kthfspe/KICAD_infrastructure/KICAD_blocks/buck_converter_26to12.kicad_sch

## KiCad design KICAD_blocks/buck_converter_26to12.kicad_sch (2026-01-20)

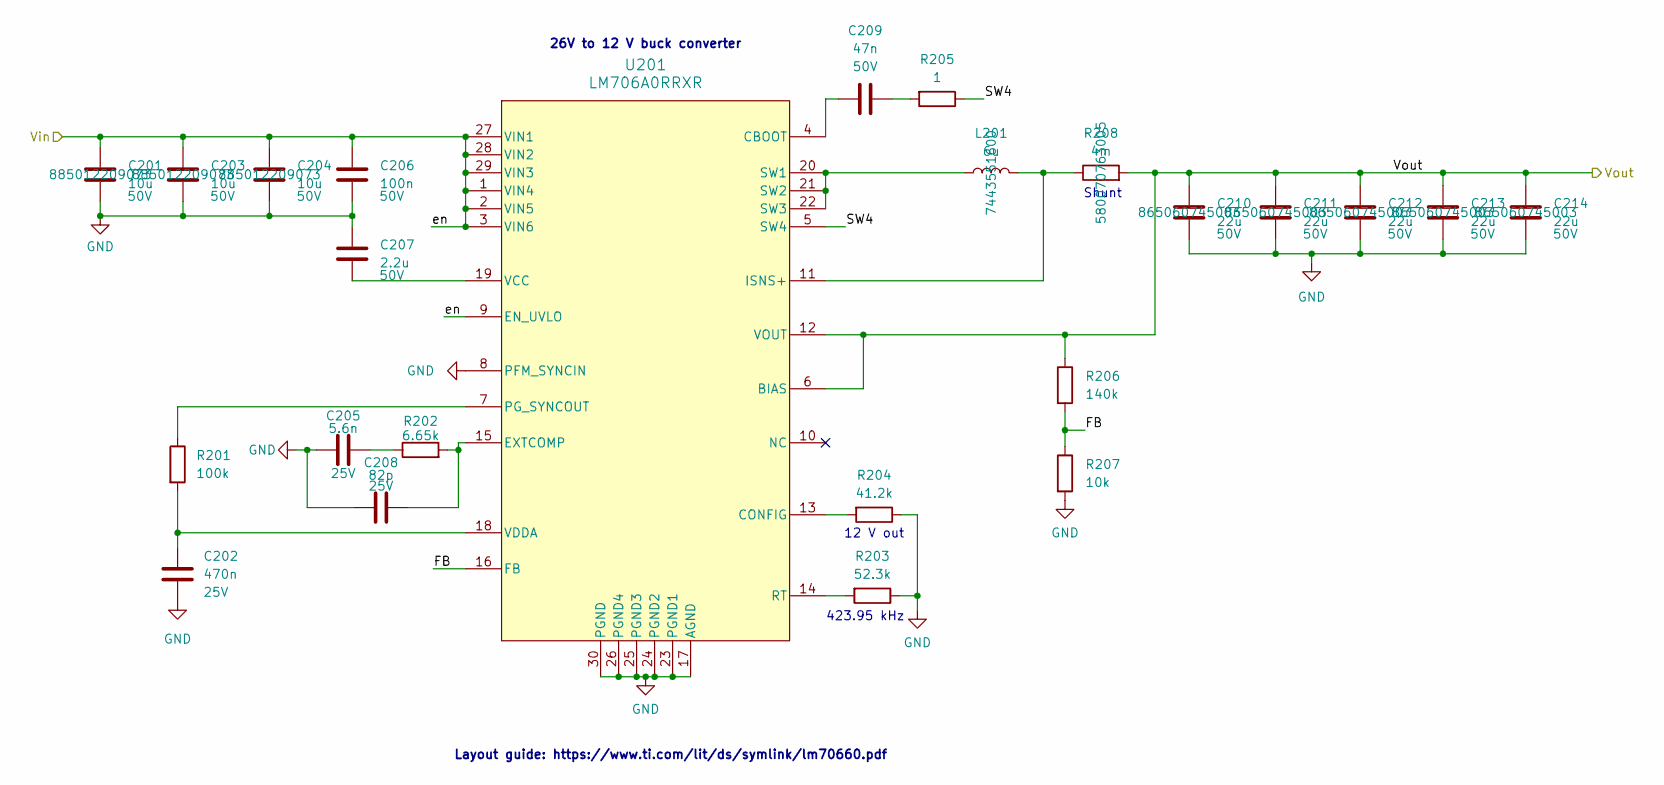
[picture p1: schematic buck_converter_26to12.kicad_sch]

Parts:
C201, C203, C204: 10u; C_1210_3225Metric; Part Number 885012209073
C202: 470n; C_0603_1608Metric
C205: 5.6n; C_0603_1608Metric
C206: 100n; C_0603_1608Metric
C207: 2.2u; C_1210_3225Metric
C208: 82p; C_0603_1608Metric
C209: 47n; C_0603_1608Metric
C210, C211, C212, C213, C214: 22u; CP_Elec_6.3x7.7; Part Number 865060745003
L201: 6u; L_Wurth_WE-HCI-1365; Part Number 7443551600
R201: 100k; R_0603_1608Metric
R202: 6.65k; R_0603_1608Metric
R203: 52.3k; R_0603_1608Metric
R204: 41.2k; R_0603_1608Metric
R205: 1; R_0603_1608Metric
R206: 140k; R_0603_1608Metric
R207: 10k; R_0603_1608Metric
R208: 4m; R_2512_6332Metric; Part Number 580070763005
U201: LM706A0RRXR; RRX0029B-MFG

Connections:
FB: R206.2, R207.1, U201.16 (FB)
GND: C201.2, C202.2, C203.2, C204.2, C205.2, C206.2, C207.1, C208.2, C210.2, C211.2, C212.2, C213.2, C214.2, R203.1, R204.1, R207.2, U201.8 (PFM_SYNCIN), U201.17 (AGND), U201.23 (PGND1), U201.24 (PGND2), U201.25 (PGND3), U201.26 (PGND4), U201.30 (PGND)
unnamed: C202.1, R201.2, U201.18 (VDDA)
unnamed: C205.1, R202.1
unnamed: C207.2, U201.19 (VCC)
unnamed: C208.1, R202.2, U201.15 (EXTCOMP)
unnamed: C209.1, U201.4 (CBOOT)
unnamed: C209.2, R205.2
unnamed: L201.1, U201.20 (SW1), U201.21 (SW2), U201.22 (SW3)
unnamed: L201.2, R208.1, U201.11 (ISNS+)
unnamed: R201.1, U201.7 (PG_SYNCOUT)
unnamed: R203.2, U201.14 (RT)
unnamed: R204.2, U201.13 (CONFIG)
SW4: R205.1, U201.5 (SW4)
Vout: C210.1, C211.1, C212.1, C213.1, C214.1, R206.1, R208.2, U201.6 (BIAS), U201.12 (VOUT)
en: C201.1, C203.1, C204.1, C206.1, U201.1 (VIN4), U201.2 (VIN5), U201.3 (VIN6), U201.9 (EN_UVLO), U201.27 (VIN1), U201.28 (VIN2), U201.29 (VIN3)

Notes on the sheet:
Shunt
26V to 12 V buck converter
Layout guide: https://www.ti.com/lit/ds/symlink/lm70660.pdf
423.95 kHz
12 V out
