kthfspe/KICAD_infrastructure/KICAD_blocks/shunt_current_sensing.kicad_sch

## KiCad design KICAD_blocks/shunt_current_sensing.kicad_sch (2026-01-20)

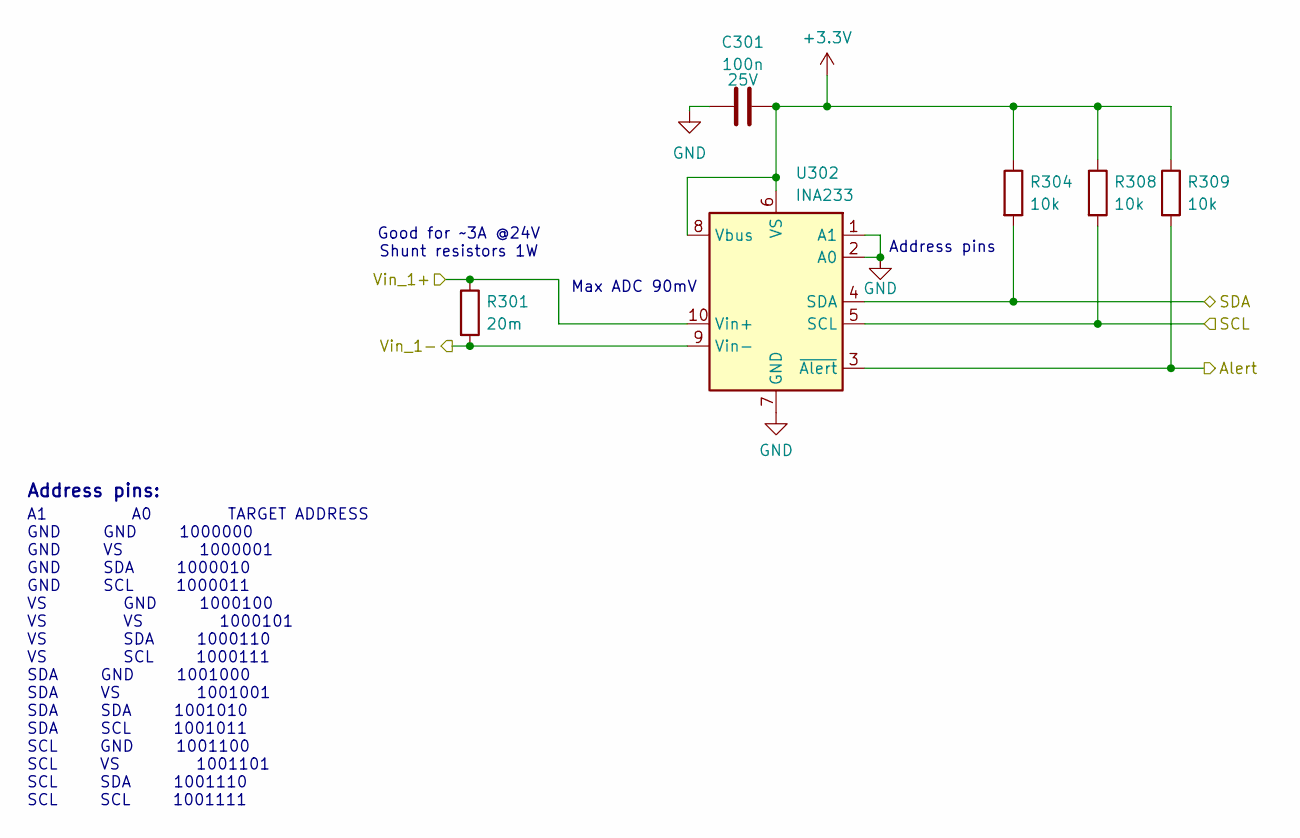
[picture p2: schematic shunt_current_sensing.kicad_sch]

Parts:
C301: 100n; C_0603_1608Metric
R301: 20m; R_2512_6332Metric
R304, R308, R309: 10k; R_0603_1608Metric
U302: INA233; VSSOP-10_3x3mm_P0.5mm

Connections:
+3.3V: C301.2, R304.1, R308.1, R309.1, U302.6 (VS), U302.8 (Vbus)
Alert: R309.2, U302.3 (~Alert)
GND: C301.1, U302.1 (A1), U302.2 (A0), U302.7 (GND)
SCL: R308.2, U302.5 (SCL)
SDA: R304.2, U302.4 (SDA)
Vin_1+: R301.1, U302.10 (Vin+)
Vin_1-: R301.2, U302.9 (Vin-)

Notes on the sheet:
Address pins:
Max ADC 90mV
A1 A0 TARGET ADDRESS GND GND 1000000 GND VS 1000001 GND SDA 1000010 GND SCL 1000011 VS GND 1000100 VS VS 1000101 VS SDA 1000110 VS SCL 1000111 SDA GND 1001000 SDA VS 1001001 SDA SDA 1001010 SDA SCL 1001011 SCL GND 1001100 SCL VS 1001101 SCL SDA 1001110 SCL SCL 1001111
Address pins
Good for ~3A @24V Shunt resistors 1W
