kthfspe/KICAD_infrastructure/blocks_KiCad8/STM32F091.kicad_sch

## KiCad design blocks_KiCad8/STM32F091.kicad_sch (2025-01-07, an earlier design)

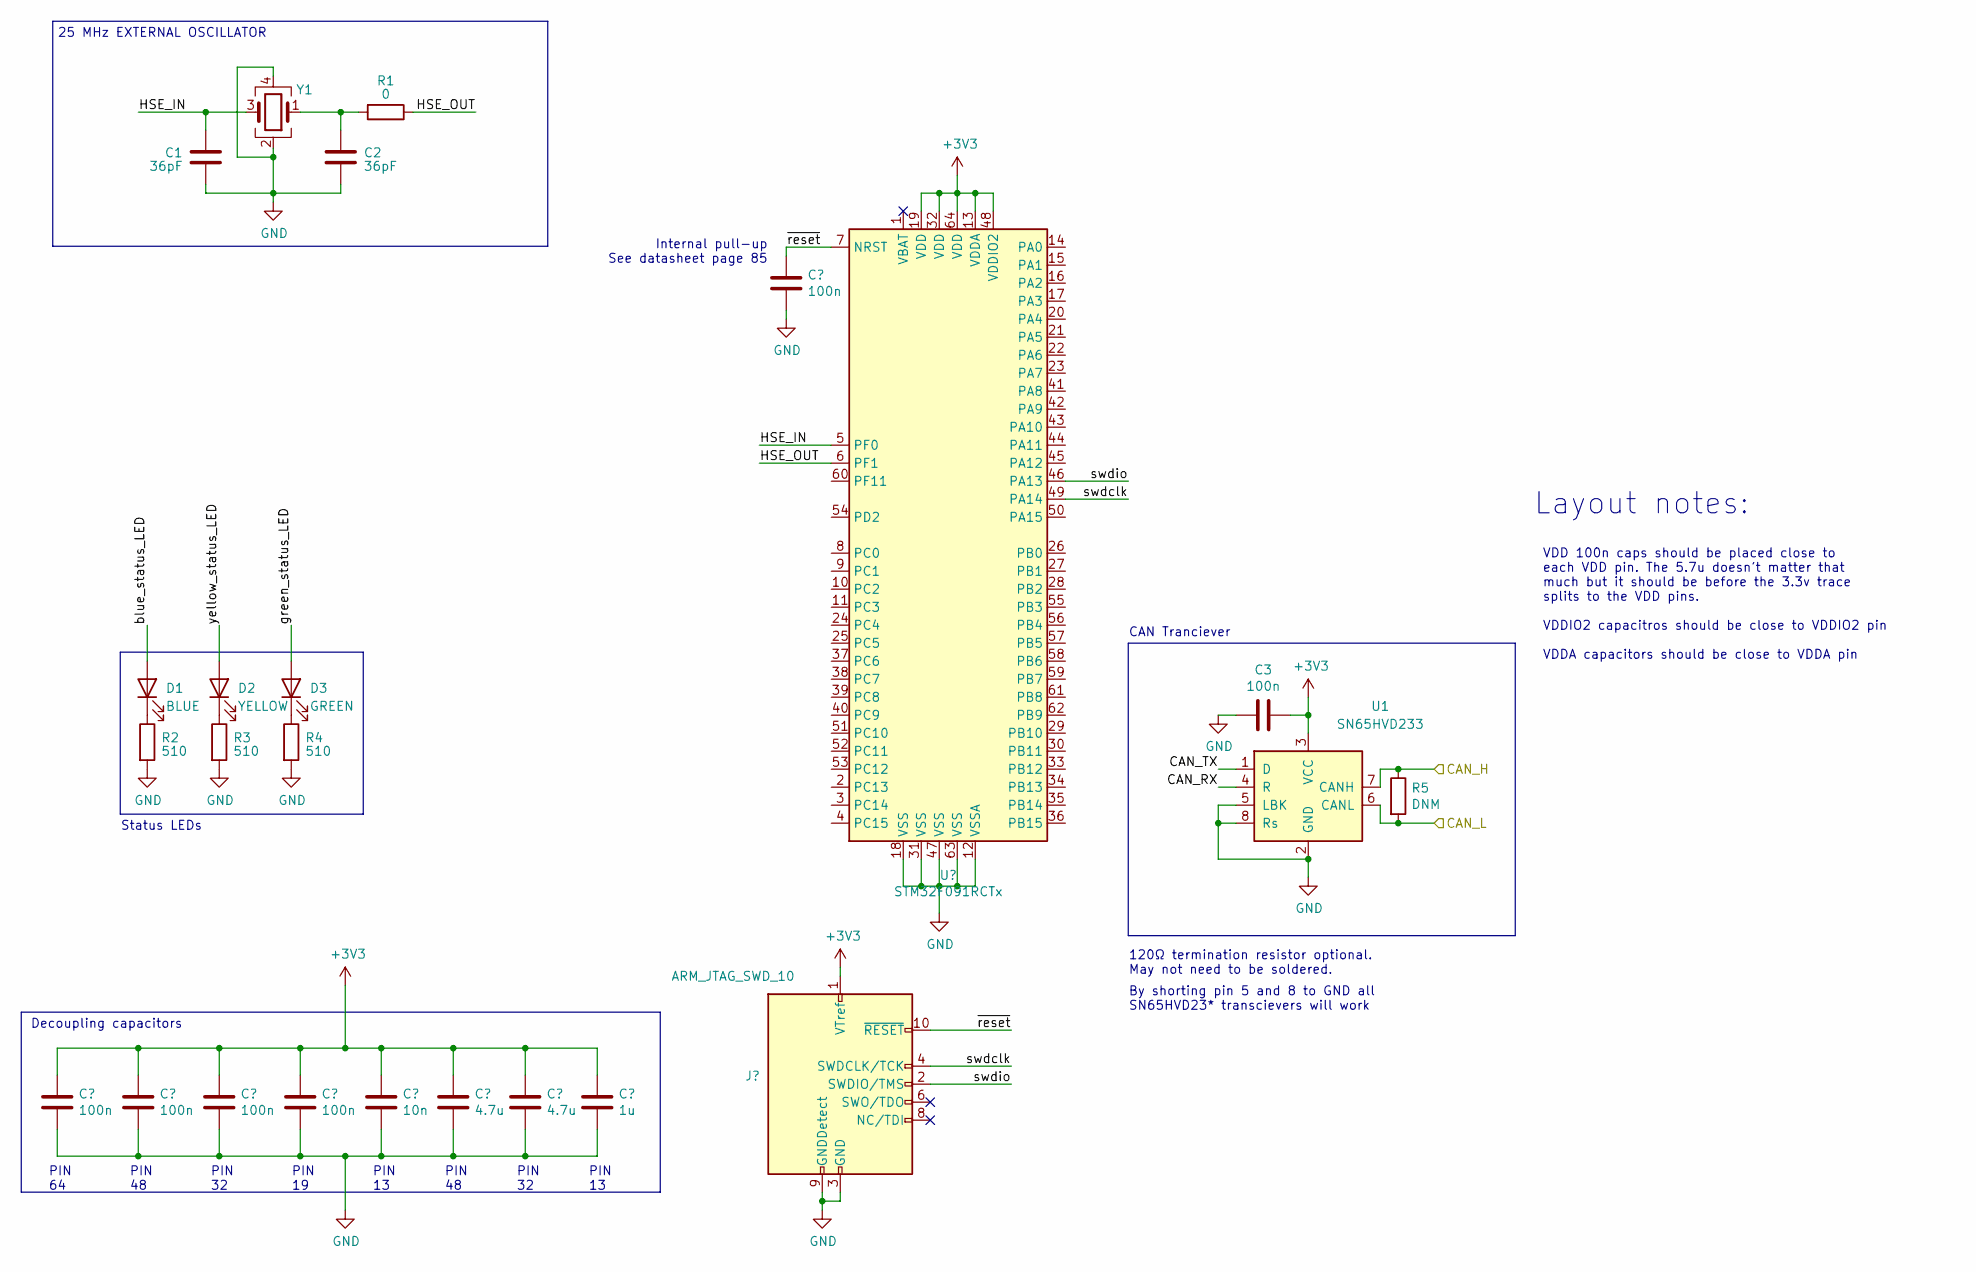
[picture p3: schematic STM32F091.kicad_sch]

Parts:
C1, C2: 36pF; C_0603_1608Metric_Pad1.08x0.95mm_HandSolder
C3: 100n; C_0603_1608Metric
D1: BLUE; LED_0603_1608Metric
D2: YELLOW; LED_0603_1608Metric
D3: GREEN; LED_0603_1608Metric
R1: 0; R_0603_1608Metric_Pad0.98x0.95mm_HandSolder
R2, R3, R4: 510; R_0603_1608Metric
R5: DNM; R_0603_1608Metric
U1: SN65HVD233; SOIC-8_3.9x4.9mm_P1.27mm
Y1: Crystal_GND24; Crystal_SMD_3225-4Pin_3.2x2.5mm_HandSoldering

Connections:
+3V3: C3.1, U1.3 (VCC)
CAN_H: R5.1, U1.7 (CANH)
CAN_L: R5.2, U1.6 (CANL)
CAN_RX: U1.4 (R)
CAN_TX: U1.1 (D)
GND: C1.2, C2.2, C3.2, R2.2, R3.2, R4.2, U1.2 (GND), U1.5 (LBK), U1.8 (Rs), Y1.2, Y1.4
HSE_IN: C1.1, Y1.3
HSE_OUT: R1.1
unnamed: C2.1, R1.2, Y1.1
unnamed: D1.1 (K), R2.1
unnamed: D2.1 (K), R3.1
unnamed: D3.1 (K), R4.1
blue_status_LED: D1.2 (A)
green_status_LED: D3.2 (A)
yellow_status_LED: D2.2 (A)

Notes on the sheet:
PIN 13
PIN 19
120Ω termination resistor optional. May not need to be soldered.
Decoupling capacitors
CAN Tranciever
PIN 48
PIN 32
VDD 100n caps should be placed close to each VDD pin. The 5.7u doesn't matter that much but it should be before the 3.3v trace splits to the VDD pins. VDDIO2 capacitros should be close to VDDIO2 pin VDDA capacitors should be close to VDDA pin
Layout notes:
25 MHz EXTERNAL OSCILLATOR
Internal pull-up See datasheet page 85
By shorting pin 5 and 8 to GND all SN65HVD23* transcievers will work
PIN 64
Status LEDs
