kthfspe/KICAD_infrastructure/blocks_KiCad9/STM32H563VITxNOTDONE.kicad_sch

## KiCad design blocks_KiCad9/STM32H563VITxNOTDONE.kicad_sch (2025-10-09)

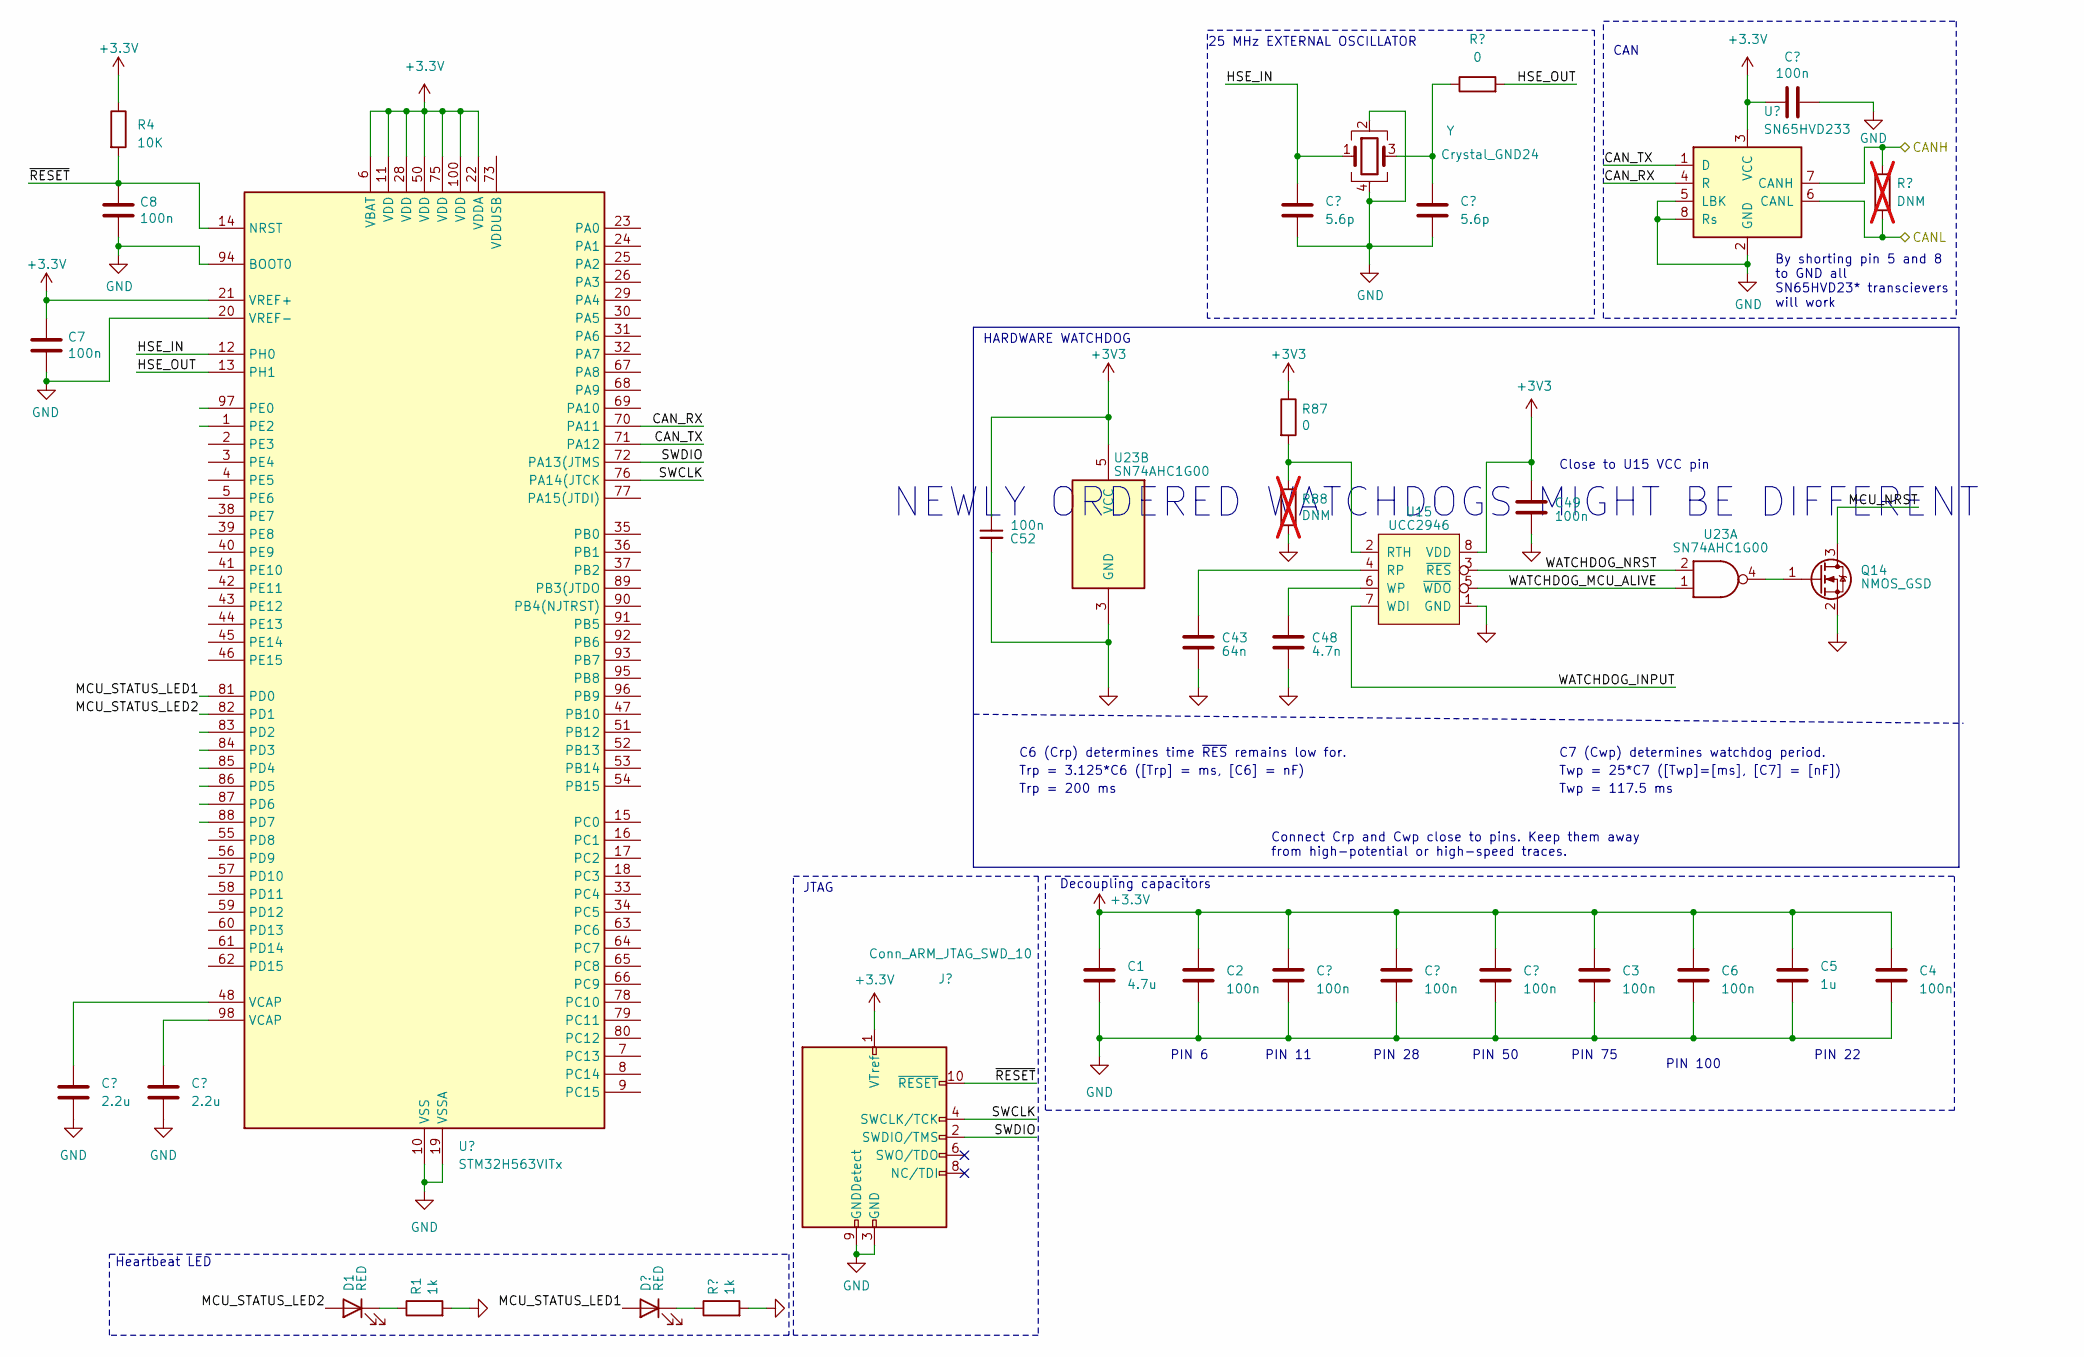
[picture p5: schematic STM32H563VITxNOTDONE.kicad_sch]

Parts:
C1: 4.7u; C_0603_1608Metric
C2, C3, C7, C11, C12, C13, C20, C49, C52: 100n; C_0603_1608Metric
C4, C6: 2.2u
C5: 1u; C_1210_3225Metric
C8, C10: 5.6p; C_0603_1608Metric
C43: 64n; C_0603_1608Metric
C48: 4.7n; C_0603_1608Metric
D1, D7: RED; LED_0603_1608Metric
J1: Conn_ARM_JTAG_SWD_10; Atmel_ICP_connector
Q14: NMOS_GSD; SOT-23
R1, R5: 1k; R_0603_1608Metric
R3, R87: 0; R_0603_1608Metric
R4: 10K; R_0603_1608Metric
R28, R88: DNM; R_0603_1608Metric; not fitted
U1: STM32H563VITx; LQFP-100_14x14mm_P0.5mm
U4: SN65HVD233; SOIC-8_3.9x4.9mm_P1.27mm
U15: UCC2946; SOIC-8_3.9x4.9mm_P1.27mm
U23: SN74AHC1G00; SOT-23-5
Y: Crystal_GND24; Crystal_SMD_2016-4Pin_2.0x1.6mm

Connections:
+3.3V: C1.1, C2.1, C3.1, C4.1, C5.1, C6.1, C7.1, C11.1, C12.1, C13.1, C20.2, J1.1 (VTref), R4.1, U1.6 (VBAT), U1.11 (VDD), U1.21 (VREF+), U1.22 (VDDA), U1.28 (VDD), U1.50 (VDD), U1.75 (VDD), U1.100 (VDD), U4.3 (VCC)
+3V3: C49.1, C52.1, R87.1, U15.8 (VDD), U23.5 (VCC)
CANH: R28.1, U4.7 (CANH)
CANL: R28.2, U4.6 (CANL)
CAN_RX: U1.70 (PA11), U4.4 (R)
CAN_TX: U1.71 (PA12), U4.1 (D)
GND: C1.2, C2.2, C3.2, C4.2, C5.2, C6.2, C7.2, C8.2, C10.2, C11.2, C12.2, C13.2, C20.1, C43.2, C48.2, C49.2, C52.2, J1.3 (GND), J1.5 (GND), J1.9 (GNDDetect), Q14.2 (S), R1.2, R5.2, R88.2, U1.10 (VSS), U1.19 (VSSA), U1.20 (VREF-), U1.27 (VSS), U1.49 (VSS), U1.74 (VSS), U1.94 (BOOT0), U1.99 (VSS), U4.2 (GND), U4.5 (LBK), U4.8 (Rs), U15.1 (GND), U23.3 (GND), Y.2, Y.4
HSE_IN: C8.1, U1.12 (PH0), Y.1
HSE_OUT: R3.2, U1.13 (PH1)
MCU_NRST: Q14.3 (D)
MCU_STATUS_LED1: D7.2 (A), U1.81 (PD0)
MCU_STATUS_LED2: D1.2 (A), U1.82 (PD1)
unnamed: C4.1, U1.48 (VCAP)
unnamed: C6.1, U1.98 (VCAP)
unnamed: C10.1, R3.1, Y.3
unnamed: C43.1, U15.4 (RP)
unnamed: C48.1, U15.6 (WP)
unnamed: D1.1 (K), R1.1
unnamed: D7.1 (K), R5.1
unnamed: Q14.1 (G), U23.4
unnamed: R87.2, R88.1, U15.2 (RTH)
SWCLK: J1.4 (SWCLK/TCK), U1.76 (PA14(JTCK)
SWDIO: J1.2 (SWDIO/TMS), U1.72 (PA13(JTMS)
WATCHDOG_INPUT: U15.7 (WDI)
WATCHDOG_MCU_ALIVE: U15.5 (~WDO), U23.1
WATCHDOG_NRST: U15.3 (~RES), U23.2
~RESET: C8.1, J1.10 (~RESET), R4.2, U1.14 (NRST)

Notes on the sheet:
PIN 50
Twp = 117.5 ms
PIN 6
Heartbeat LED
NEWLY ORDERED WATCHDOGS MIGHT BE DIFFERENT
PIN 28
25 MHz EXTERNAL OSCILLATOR
JTAG
C7 (Cwp) determines watchdog period.
Twp = 25*C7 ([Twp]=[ms], [C7] = [nF])
PIN 100
C6 (Crp) determines time ~{RES} remains low for.
By shorting pin 5 and 8 to GND all SN65HVD23* transcievers will work
PIN 75
CAN
PIN 22
PIN 11
Decoupling capacitors
Trp = 200 ms
Trp = 3.125*C6 ([Trp] = ms, [C6] = nF)
Connect Crp and Cwp close to pins. Keep them away from high-potential or high-speed traces.
HARDWARE WATCHDOG
Close to U15 VCC pin
