kthfspe/KICAD_infrastructure/(threads)

Thread 5 (2020-12-19):

FOOTPRINT WRONG! don't panic!

HolgerStenberg, 2020-12-19:
very 6 pin flawed. Need to check this out!
