kthfspe/KICAD_infrastructure/(commit log)

2019-03-27 added testhook footprint
2019-03-29 3d fuse
2019-04-17 added T9A relay
2019-04-21 added dual mosfet driver
2019-08-26 enhancement mosfet
2019-09-02 added PowerPAK8
2019-10-05 added DIP_4 switch
2019-10-10 added hv triangle, wurth wbt 2pin mpc3 pin
2019-10-15 added 6pdt switch
2019-11-27 deleted KT05 footprint
    Was changed to KTxx in 31e404a
2019-12-03 added templates
    Added an empty project template
    [KTHFS_empty_project.kicad_pcb, KTHFS_empty_project.sch]
2019-12-04 added blocks
    added some empty blocks placeholders
    [24_to_5_supply.sch, 5_to_3.sch, CAN_transceiver.sch, blocks.kicad_pcb, blocks.sch]
2019-12-04 minor changes on blocks
    [5_to_3.sch, Wurth_LED_driver.sch, blocks.sch]
2019-12-05 added multiple schematics
    [24_to_5_supply.sch, 5_to_3.sch, CAN_transceiver_3.3.sch, CAN_transciever_5.sch, blocks.sch, current_signaling_receiver.sch, current_signaling_transmitter.sch]
2019-12-06 added LED footprint with heatpads
2019-12-06 changes on blocks
    - added led in power supply
    - added wurth led driver
    [24_to_5_supply.sch, Wurth_LED_driver.sch]
2020-03-16 added lm321
    [24_to_5_supply.sch, current_signaling_receiver.sch]
2020-04-04 added 10 position rotrary switch
2020-04-13 added wurth mpc4 4 pin
2020-04-13 added wurth mpc4 3 pin
2020-04-13 added wurth mm 12 pin
2020-04-15 added wurth mm 14 pin
2020-05-17 encoder symbol
2020-05-17 8 rotary encoder
2020-06-06 added potentiometer footprint
2020-06-07 changed trimpot footprint and 3d model
2020-06-09 added wbt 6 pin
2020-06-16 added 4.4v can transciever
    [CAN_transceiver_3.3.sch]
2020-06-24 added footprints for led driver
    [Wurth_LED_driver.sch]
2020-06-24 pcb DRC number in block template
    [blocks.kicad_pcb]
2020-07-16 added wbt 2.00mm footprint
2020-07-16 added 10 and 14 pin wbt 2.00mm
2020-09-15 added 19 pin lemo
2020-09-30 added mpc4 2 and 3 pin vertical
2020-10-03 Fixed footprint
2020-10-26 changed wurth iso dcdc footprints and symbol
2020-11-09 added STM32F0 block
    [STM32F091.sch, blocks.sch]
2020-11-13 changed 3.3 can to sn65hvd233
    [CAN_transceiver_3.3.sch]
2020-11-15 added lcd connector
2020-11-27 Added wurth MPC4_angle_2x2 connector
2020-11-27 Added Wurth-WBT_2.54_male_angle_2 connector
2020-11-27 Added Wurth-WBT_2.54_male_angle_2 connector
    61900619521
2020-11-29 Added pin 1 indication and pin references
2020-12-19 hotfix, hole size for wurth WTB vert 6 pin
2020-12-21 added 14 pin WTB vert, almost identical to the 6x2 vert
2020-12-22 name change, for MPC4 connector
2021-01-24 Added pin type description
2021-02-04 Heatpad was mirrored. Now fixed.
2021-02-13 adding the footprint
2021-02-15 Create emil_tagesson.kicad_mod
    My logo
2021-06-03 added footprint, ready for review
2022-04-27 Footprint files for WR-TBL added
2022-04-28 Changed to KiCAD V5 compatible footprint
2023-02-26 Added new wurth BMS transformer
2023-03-07 Added WE-SL2 CM Choke footprint
2023-09-20 Updated the block library
    Updated the block library to KiCad7
    [24_to_5_supply.kicad_sch, 24_to_5_supply.sch, 5_to_3.kicad_sch, 5_to_3.sch, CAN_transceiver.sch, CAN_transceiver_3.3.kicad_sch, CAN_transceiver_3.3.sch, CAN_transciever_5.kicad_sch]
2023-09-20 Revert "Updated the block library"
    This reverts commit a355e8685ff60d51c8df7a2b7570d2adc357842b.
    [24_to_5_supply.kicad_sch, 24_to_5_supply.sch, 5_to_3.kicad_sch, 5_to_3.sch, CAN_transceiver.sch, CAN_transceiver_3.3.kicad_sch, CAN_transceiver_3.3.sch, CAN_transciever_5.kicad_sch]
2023-09-20 Updated blocks to now also have a kicad7 compatible library
    [24_to_5_supply.kicad_sch, 24_to_5_supply.sch, 5_to_3.kicad_sch, 5_to_3.sch, CAN_transceiver.sch, CAN_transceiver_3.3.kicad_sch, CAN_transceiver_3.3.sch, CAN_transciever_5.kicad_sch]
2023-11-08 Add becky HV board footprints
2023-11-08 modified footprint
2023-11-08 redcube 7461098 footprint added
2023-11-08 footprint redcube 7461103 added
2023-11-08 changed name of footprint
2023-11-08 Becky2.0 HV board footprints
2023-11-09 removed GND pads on AIR footprint
2023-11-09 Change hall sensor footprint
2023-11-10 redcube footprints modified
    [STM32F091.kicad_sch, STM32F091.sch]
2023-12-07 Added FINDER 50.12 Relay footprint
2023-12-14 Added Wurth MPC3 connectors
2023-12-14 Added AMPSEAL connector
2023-12-19 Added new connector (fronbox)
2023-12-19 Added new footprint and adjusted path
2023-12-21 Added Wurth-MM_26 footprint
2023-12-28 Added Phoemix M8 5 and 3 pin connector
2023-12-28 Added MPC footprints
2023-12-28 Change pin numbering
2023-12-28 Updated and corected footprints
2023-12-31 Add some rear fairing connector footprints + cads
2024-01-04 Create DeV17_logo.kicad_mod
    Added logo of DeV17
2024-01-16 Increased hole size to 0.635*sqrt(2)
2024-01-18 Rename MM connector
2024-01-21 added LED driver TPS92611
2024-01-23 TPS92611QDGNRQ1
    Updated footprint according to the datasheet
2024-01-28 TPS92611QDGNRQ1
    Reduce soldermask opening for the pins.
2024-01-28 adjusted sot-23-5 footprint
2024-01-28 change 3d files for wurth mpc3 footprints
2024-02-01 Added WTB 3 pin angle
2024-02-10 added connector
2024-02-11 added modified debugger footprint
    Eurocircuits require larger annular width
2024-02-12 add "breakoff hole" NPTH pad for creating breakable pcb
2024-02-19 added 3d model for LED driver
2024-03-19 added logo to drawing sheet
    [KTHFS_empty_project.kicad_sch, KTHFS_empty_project.sch]
2024-05-06 Create DeV18_mounting_hole_vias_3.2mm_battery_pole.kicad_mod
    mounting hole battery measurment pcb
2024-05-06 added KTHFS logogs for silkscreen in differnt sizes :)
2024-11-01 Added WL-SMRD SMT Mono-color Reverse Mount Diffused
2024-11-17 added slave footprints
2024-11-27 added super seal connector
2024-12-11 added mp7200 led driver
2024-12-20 made smd pinheader pad made larger
    For easier soldering on the measurement pcb and slaves
2024-12-20 Adjusted standard blocks
    Updated to kicad 8, changed tvs symbol
    [24_to_5_supply.kicad_sch, 5_to_3.kicad_sch, CAN_transceiver_3.3.kicad_sch, CAN_transciever_5.kicad_sch, STM32F091.kicad_sch, Wurth_LED_driver.kicad_sch, blocks.kicad_sch, current_signaling_receiver.kicad_sch]
2024-12-22 Widened pads for smd pinheader, adjusted silkscreen
2025-01-03 added wurth inductor footprint
    WE-TPC_1028_103892
2025-01-04 minor change to kthfs logo
    removed reference silkscreen
2025-01-04 changed soldermask om ltc3114 footprint
    Set so it follows netclass
2025-01-07 changed standard blocks, minor changes to some footprints
    Adjusted solder mask expansion on debug connector
    Added TPS7A LDO footrpint and symbol
    Added crystal to MCU standard block.
    Added status lights to MCU standard block.
    [STM32F091.kicad_sch]
2025-05-06 updated standard blocks to kicad 9, modified f09 block
    Added watchdog and pull up to reset pin after issues with ECU
    [24_to_5_supply.kicad_sch, 5_to_3.kicad_sch, CAN_transceiver_3.3.kicad_sch, CAN_transciever_5.kicad_sch, STM32F091.kicad_sch, STM32F407.kicad_sch, Wurth_LED_driver.kicad_sch, blocks.kicad_sch]
2025-08-28 Added Infineon MOSFET module
2025-08-28 Added LEM current sensor
2025-08-28 Added DC link capacitors
2025-08-29 Added gate driver PSU
2025-09-02 Added power pcb components
2025-09-03 Update KiCad libraries and footprints
2025-09-03 added dcdc +-5 and depleation fet
2025-09-08 New footprints added
2025-09-09 add my logo footprint
2025-09-29 Added footprints
2025-10-07 STM32H563VITx NOT FULLY DONE
    needs to assign pins for decoupling capacitors aswell need to adjust to other Clock.
    [STM32H563VITxNOTDONE.kicad_sch]
2025-10-08 Update on the STM32H563VITx
    Only thing left is double checking the hardware watchdog since we ordered different ones.
    [STM32H563VITxNOTDONE.kicad_sch]
2025-10-09 minor changes to mcu block
    oscillator footprint and some other smaller changes for labels.
    [STM32H563VITxNOTDONE.kicad_sch]
2025-10-11 STM32H563VITx done (UNREVIEWED)
    New hardware watchdog implementation and rest is done aswell.
    [STM32H563VITx.kicad_sch]
2025-10-15 Added some footprints
2025-10-17 Added symbols and footprint for FPGA
2025-11-06 small change to MCU
    boot pin resistor and jumper for debugging purposes
    [STM32H563VITx.kicad_sch]
2025-11-13 forgot footprint mcu
    [STM32H563VITx.kicad_sch]
2025-12-02 fixed wrong footprint
2025-12-08 Added william_stenbergs signature footprint
2025-12-08 updated footprint to correct version
2026-01-19 Added 12 V 10A buck and current sensing circuitry
    [KICAD_blocks.kicad_pcb, KICAD_blocks.kicad_sch, buck_converter_26to12.kicad_sch, shunt_current_sensing.kicad_sch]
2026-02-11 changed rev mounted led footprint
2026-02-11 Footprint and symbols for measurement pcb
2026-11-01 Added i2c buffer
2026-11-10 updated mpc2x2_updated so positioner holes are in correct position
